kakao-workshop/spacesmart/docs/images/device-screens.png

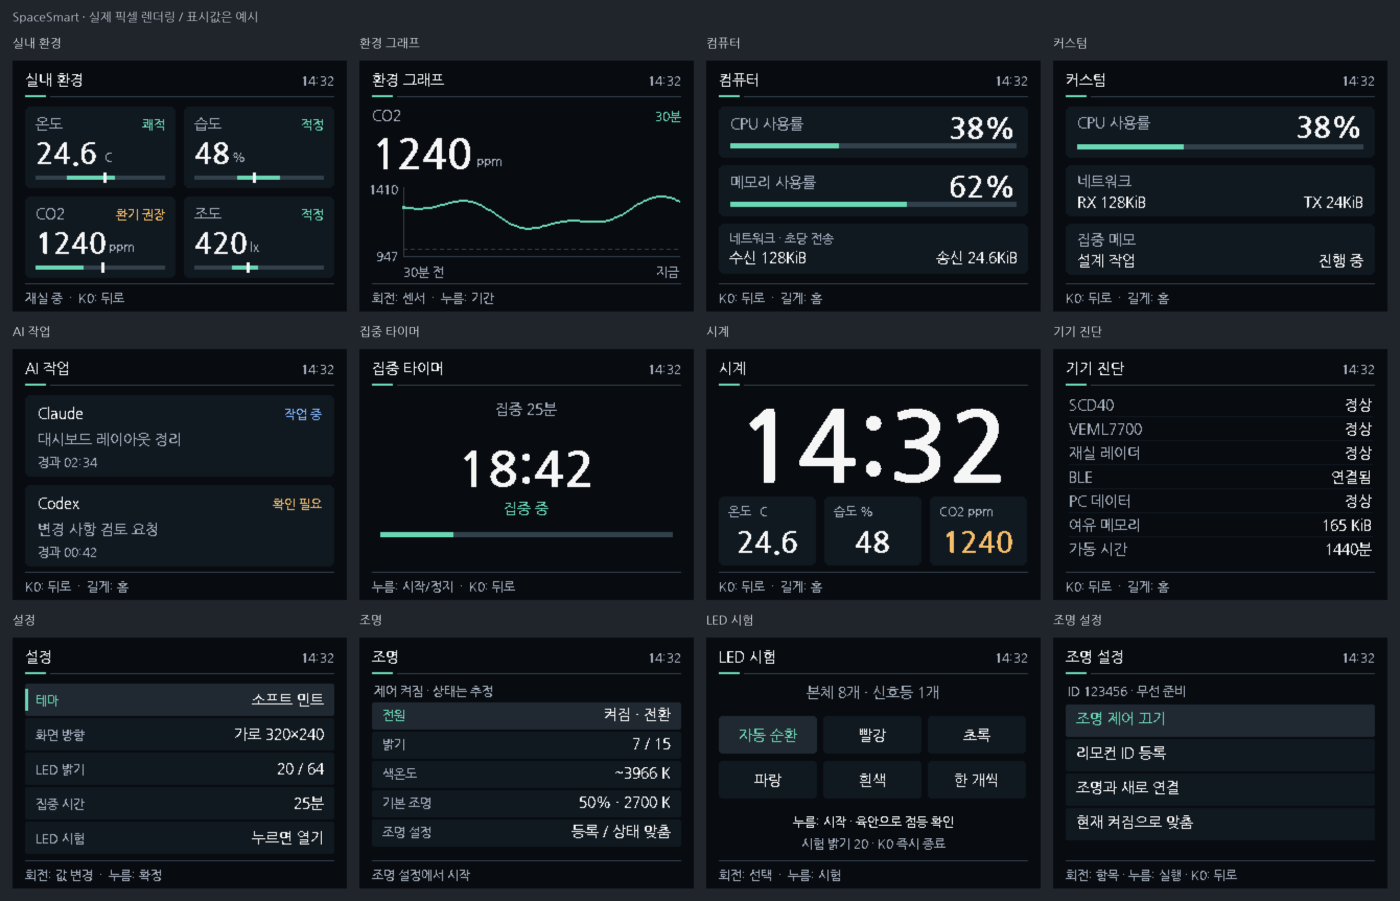
docs/images/device-screens.png
