kakao-workshop/spacesmart/formwork/RevU/dc-slider.png

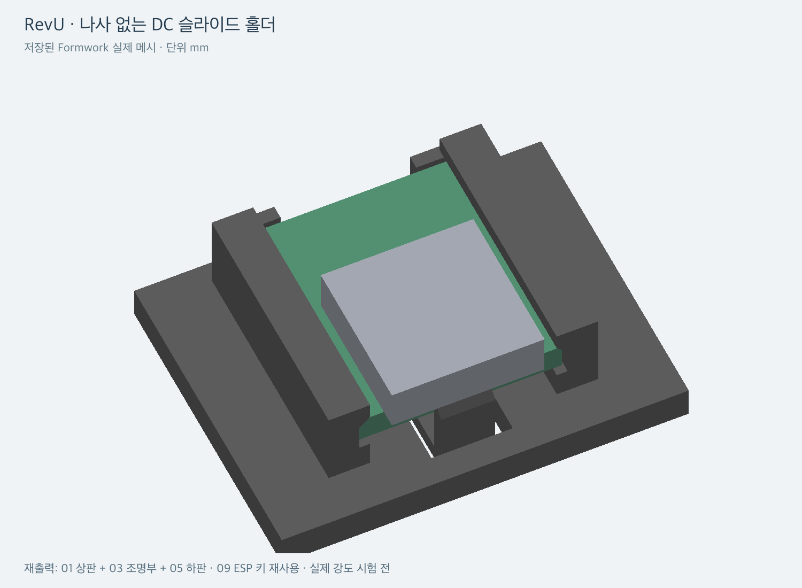
formwork/RevU/dc-slider.png
