kakao-workshop/spacesmart/formwork/RevU/joint-sections.png

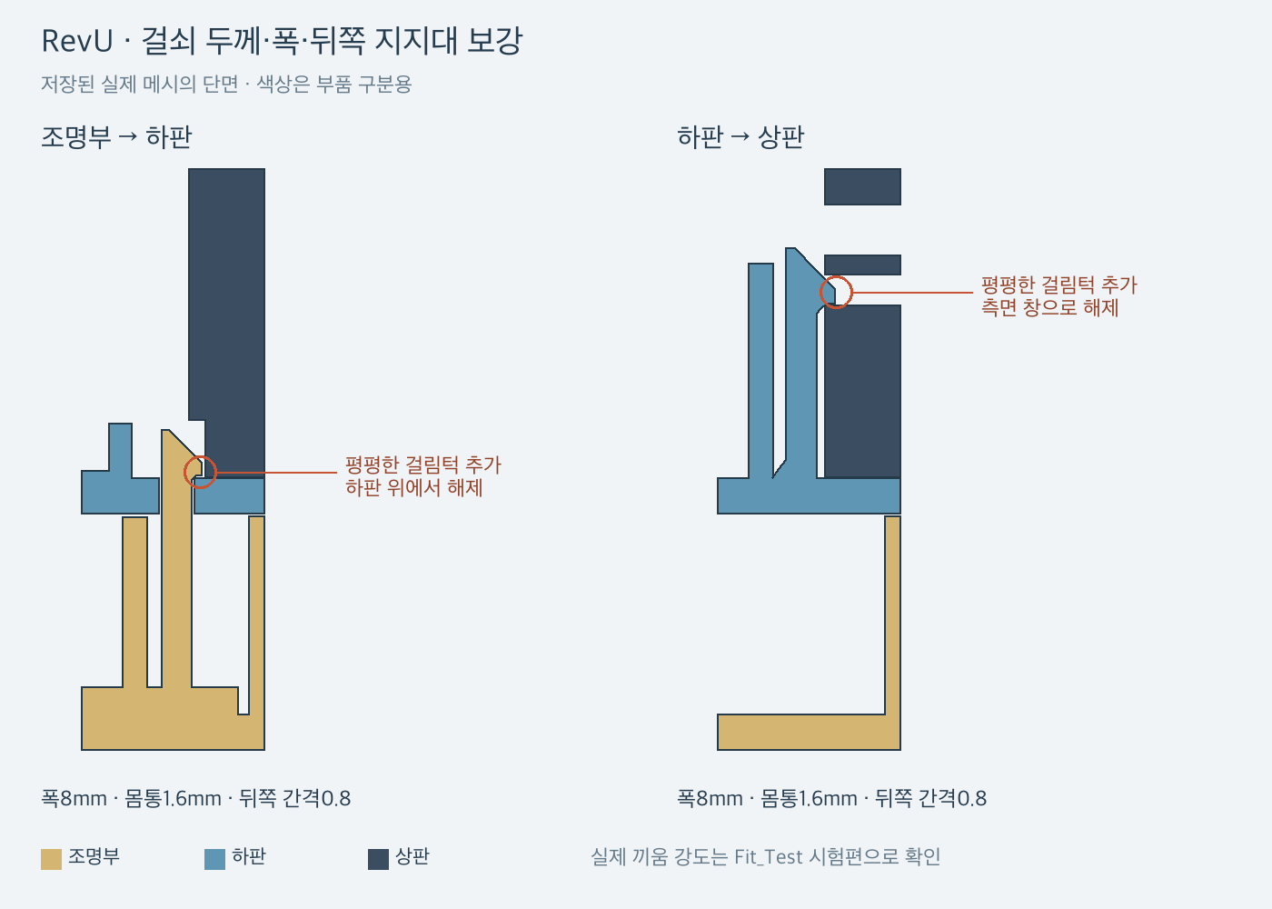
formwork/RevU/joint-sections.png
