kakao-workshop/spacesmart/formwork/RevU/model-joints.png

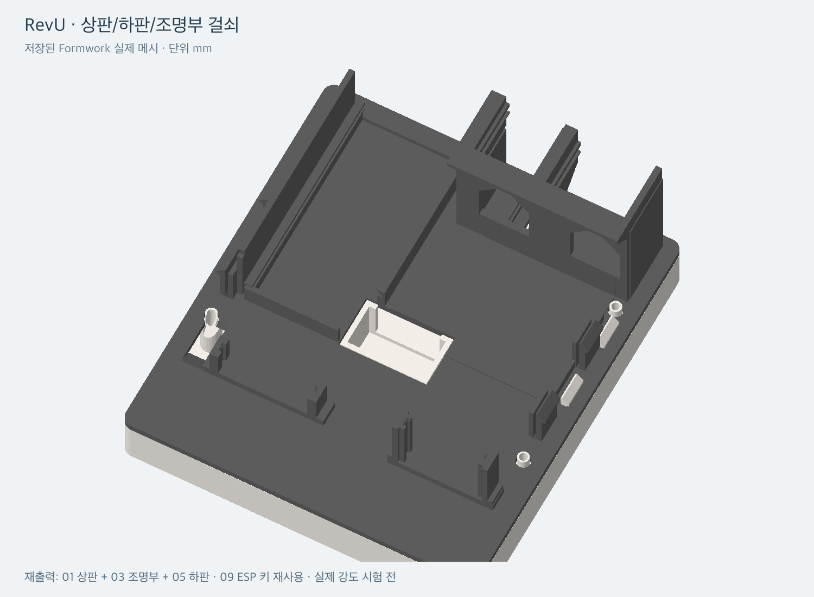
formwork/RevU/model-joints.png
