kakao-workshop/spacesmart/formwork/RevU/STL/01_main_body_black.stl

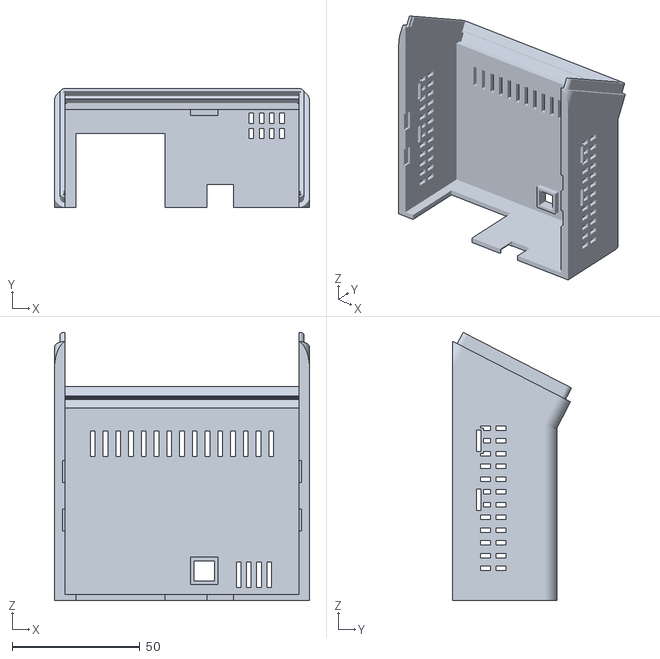
[picture p7: CAD file, 2026-11-02]
formwork/RevU/STL/01_main_body_black.stl
100.0 x 46.7 x 105.3
