kakao-workshop/spacesmart/formwork/RevU/Fit_Test/TEST_03_shell_socket_black.stl

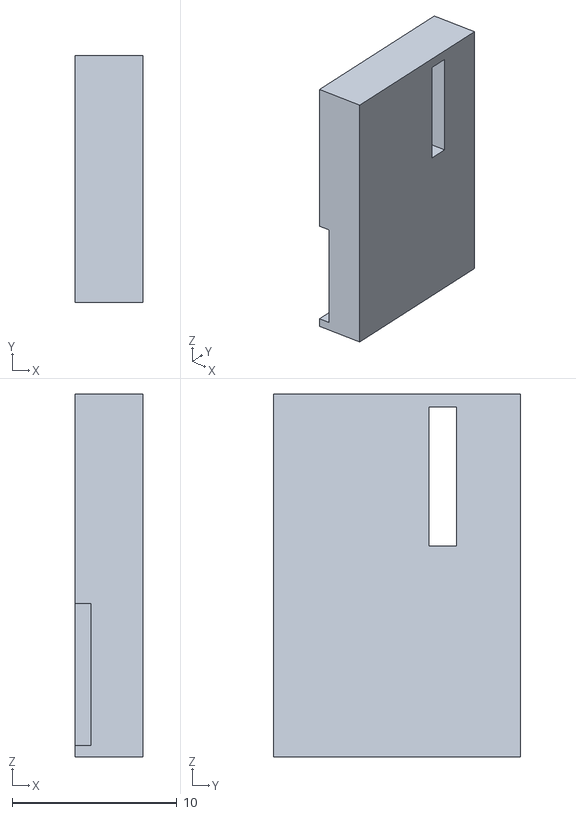
[picture p8: CAD file, 2026-11-02]
formwork/RevU/Fit_Test/TEST_03_shell_socket_black.stl
4.10 x 15.0 x 22.0
