kakao-workshop/spacesmart/formwork/RevU/RevU_A1_0p12_support_off_checked.3mf

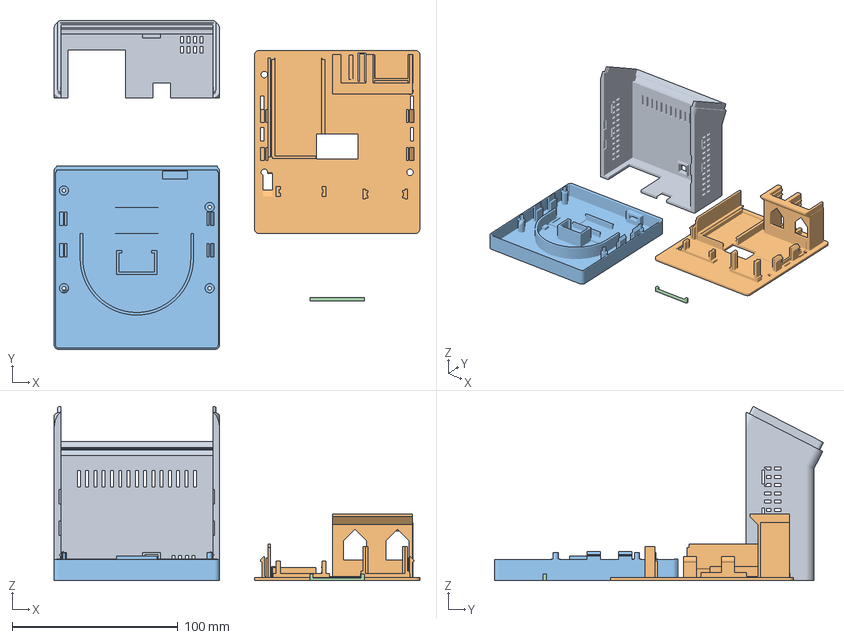
[picture p9: CAD file, 2026-11-02]
formwork/RevU/RevU_A1_0p12_support_off_checked.3mf
221.0 x 198.7 x 105.3 mm
01_main_body_black.stl
05_integrated_slot_tray_black.stl
03_integrated_lower_base_white.stl
09_esp_retainer_black.stl
