kakao-workshop/spacesmart/formwork/RevU/Fit_Test/TEST_02_tray_clip_black.stl

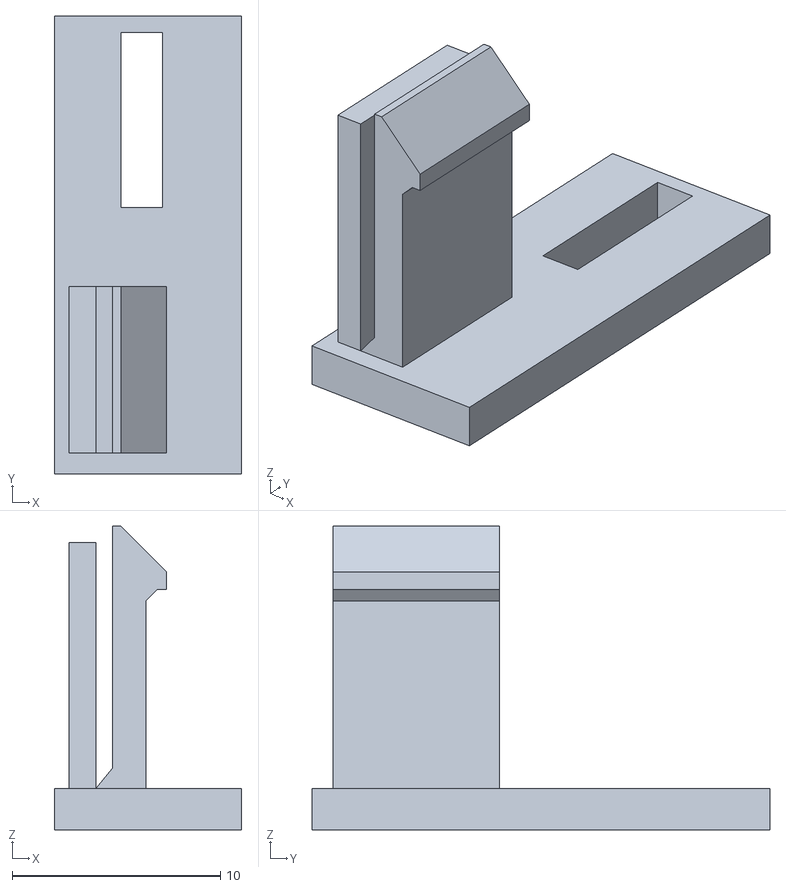
[picture p10: CAD file, 2026-11-02]
formwork/RevU/Fit_Test/TEST_02_tray_clip_black.stl
9.00 x 22.0 x 14.6
