kakao-workshop/spacesmart/formwork/RevU/STL/05_integrated_slot_tray_black.stl

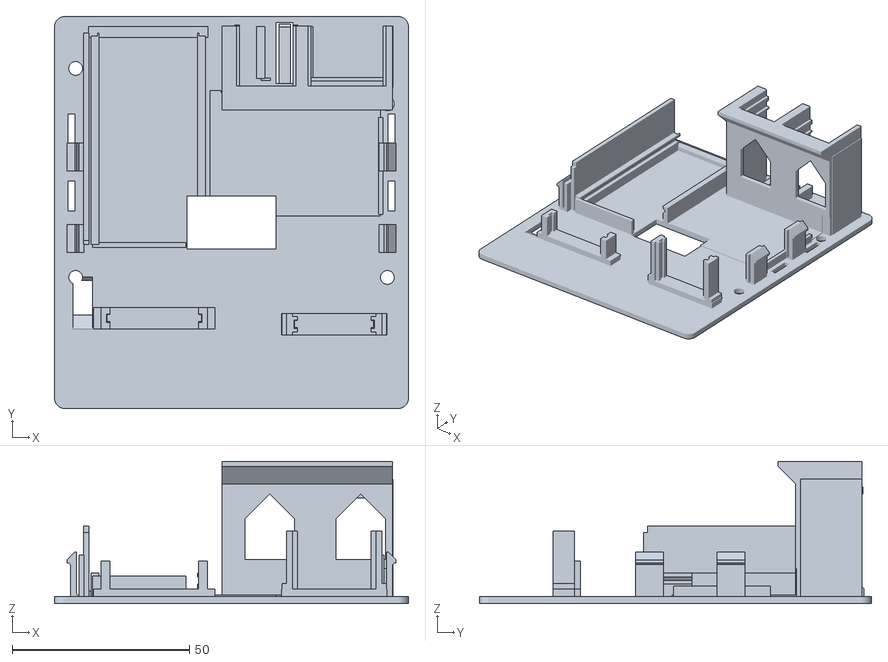
[picture p11: CAD file, 2026-11-02]
formwork/RevU/STL/05_integrated_slot_tray_black.stl
100.0 x 110.7 x 40.2
