kakao-workshop/spacesmart/formwork/RevU/Fit_Test/TEST_01_lower_clip_white.stl

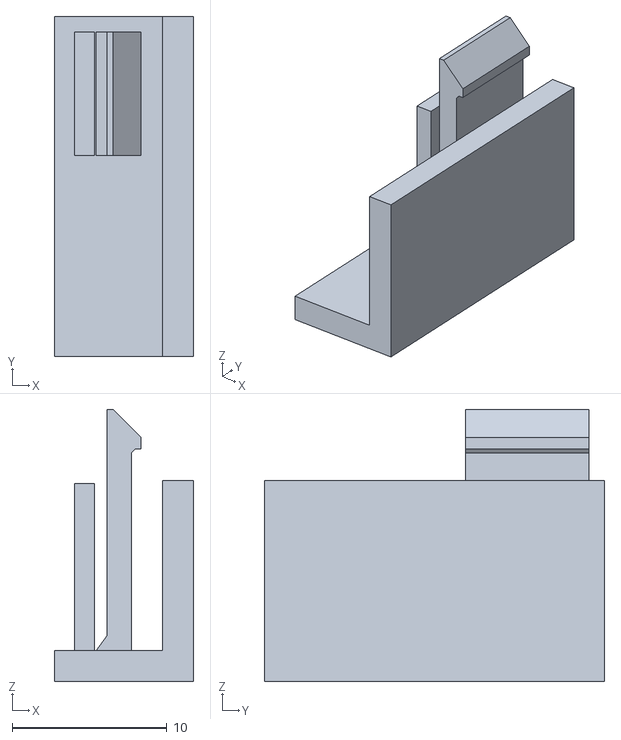
[picture p12: CAD file, 2026-11-02]
formwork/RevU/Fit_Test/TEST_01_lower_clip_white.stl
9.00 x 22.0 x 17.6
