kakao-workshop/spacesmart/formwork/RevU/STL/03_integrated_lower_base_white.stl

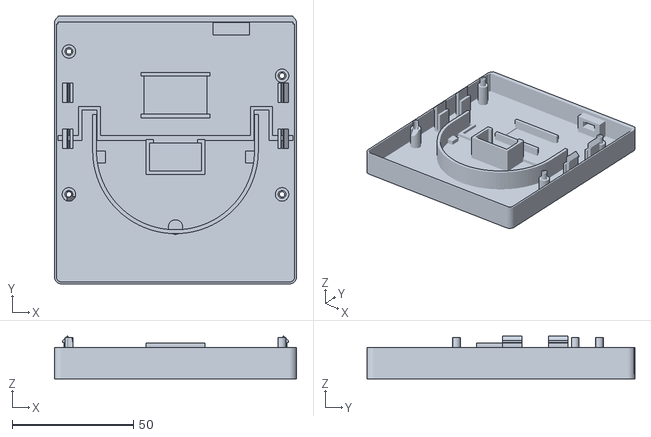
[picture p13: CAD file, 2026-11-02]
formwork/RevU/STL/03_integrated_lower_base_white.stl
100.0 x 110.7 x 17.6
