kakao-workshop/spacesmart/formwork/RevU/STL/09_esp_retainer_black.stl

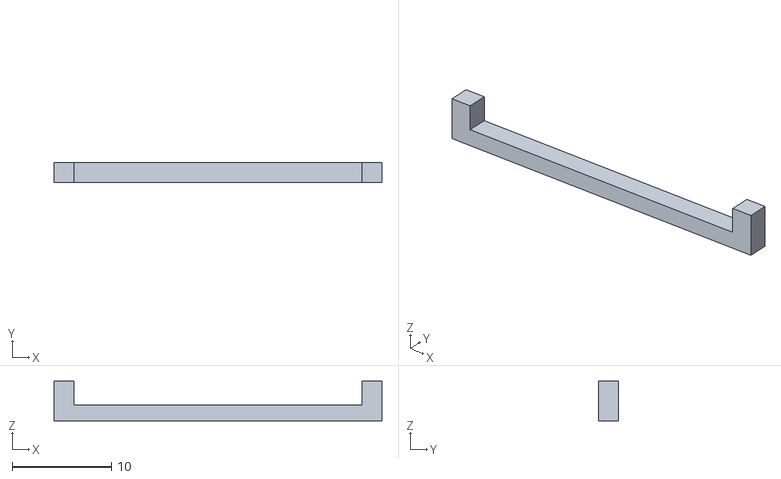
[picture p14: CAD file, 2026-11-02]
formwork/RevU/STL/09_esp_retainer_black.stl
33.0 x 2.00 x 4.00
