kakao-workshop/spacesmart/formwork/RevU/STL/02_original_front_optional_black.stl

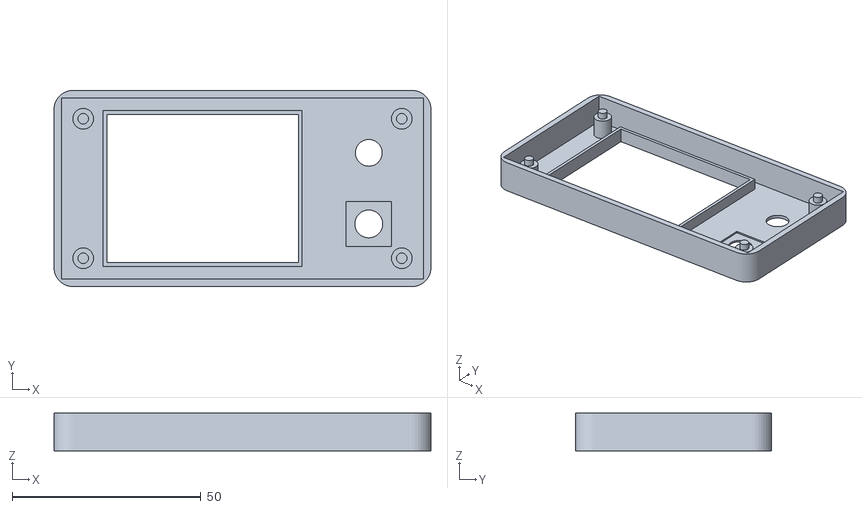
[picture p15: CAD file, 2026-11-02]
formwork/RevU/STL/02_original_front_optional_black.stl
100.0 x 52.0 x 10.0
