kakao-workshop/spacesmart/Arduino/wiring/revk-power-direct-wiring.png

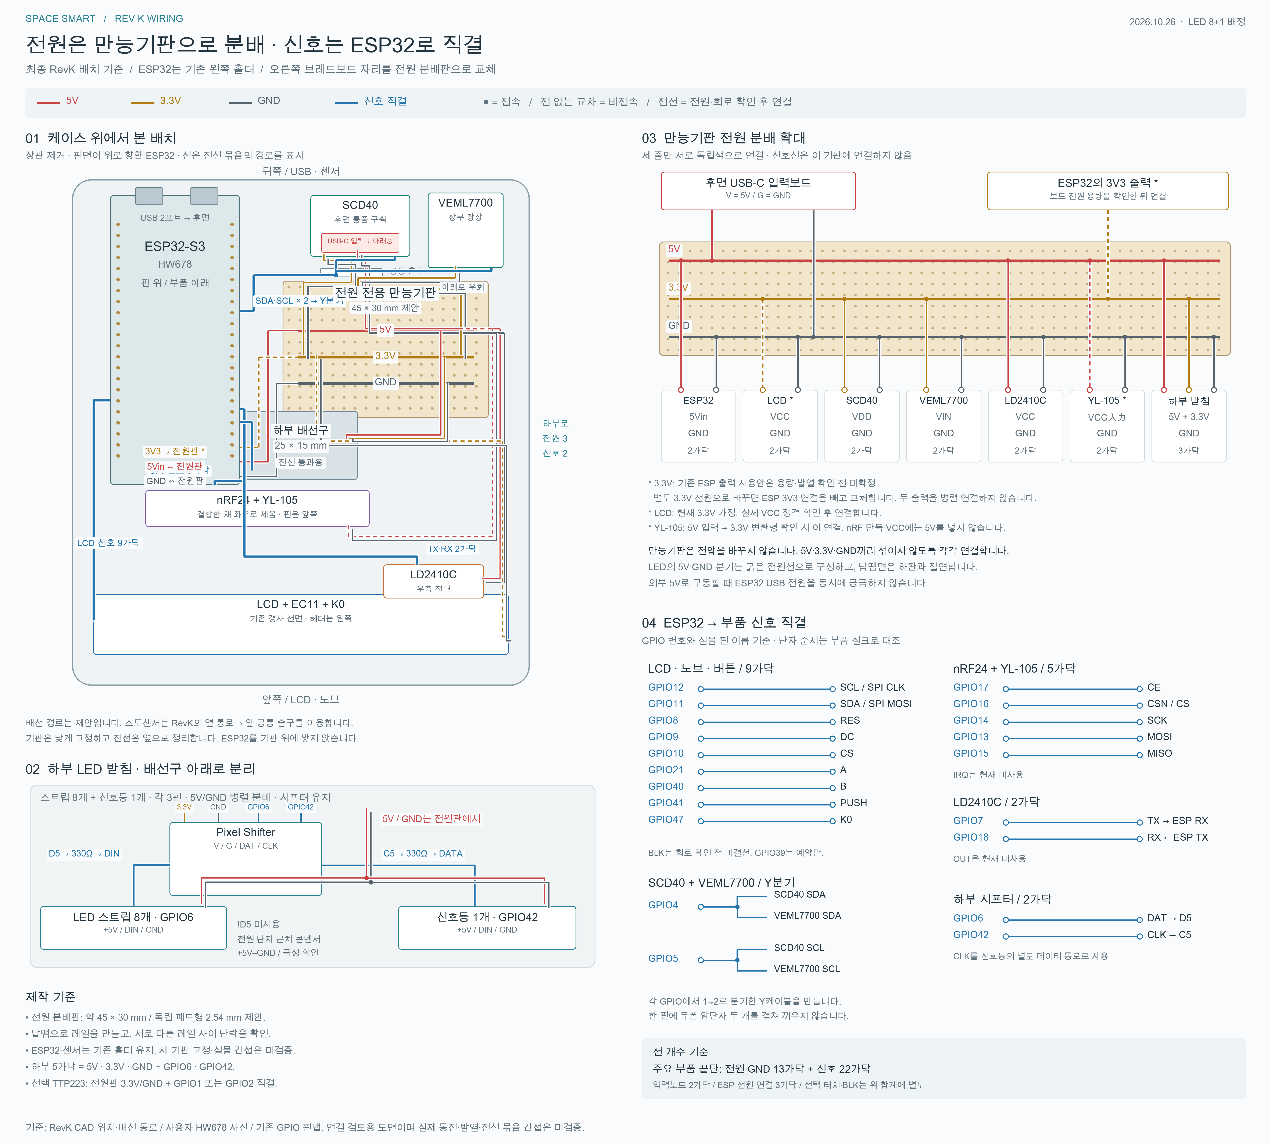
Arduino/wiring/revk-power-direct-wiring.png
