kakao-workshop/spacesmart/docs/VERIFICATION.md

# 검증 범위

기준일: 2026-11-02. 이 문서는 확인한 범위와 아직 실물 확인이 필요한 부분을 구분합니다.

## 완료한 확인

- Arduino: ESP32-S3 N16R8 설정 컴파일, 20개 GPIO와 배선 CSV 대조, 대시보드·노브·LED 시험 로직, 레이더 프레임 파싱.
- 화면: 네 가지 테마·두 방향·12개 화면 상태, 데이터 없는 화면까지 120개 렌더링 검사.
- 실제 기존 디바이스: LCD·온습도·CO₂·조도·재실, LED 기능 활성화, nRF24 칩 응답, Bluetooth와 PC 데이터 전송 확인. 시계·커스텀 화면은 사용자 확인 완료.
- macOS: Apple Silicon/Intel universal 빌드, 서명 검사, 설치·재설치·연동 해제 시 다른 설정 보존, 개인정보 필터·상태 만료, 커스텀 저장.
- v1.3 UI: 단일 창 메뉴 이동, 조명에서 개요 복귀, 단축키, 붙여넣기, 커스텀 입력 유지·저장, 미저장 종료 보호, 작은 창 스크롤, 실제 Bluetooth 재연결과 PC 사용량 갱신.
- 조명 로직: 알려진 패킷 CRC, 수신 정렬, 단계 조절·시간 제한, 명령 보호, 학습 개수·시간·밝기 조건, 위치 분리·저장, 통신 단절 시 자동 조절 중지.
- 케이스 RevU: 저장된 메시·삽입 경로·단면·Bambu A1 슬라이싱 보고서. [세부 보고서](../formwork/RevU/validation-report.json).

공개 저장소의 재구성 후에도 펌웨어 컴파일, C++/Swift 테스트, STL 재생성, macOS universal 빌드와 패키지 검사를 실행합니다.

## 아직 확인이 필요한 범위

- 실제 MJGJD01YL의 RF 제어·원래 리모컨 캡처·현장 밝기 학습·자동 제어.
- v2.3 조명 명령의 전체 실물 통합 동작, 전원 재인가 후 NVS 복원.
- LED 시험 메뉴에서 실제 배선별 LED 점등을 눈으로 확인하는 작업.
- Intel Mac 실물, macOS 13 실물, 새 사용자 계정의 Gatekeeper 설치 흐름.
- 실제 Claude/Codex 앱의 모든 작업 시작·권한 대기·오류·완료 경로.
- 케이스 출력 후 걸쇠 유지력·반복 조립 수명·센서 광학 영향.

컴파일과 테스트는 보드에 자동으로 업로드하지 않습니다. 실제 업로드 시에는 대상 보드를 먼저 확인하세요.
