kakao-workshop/spacesmart/Arduino/docs/CHANGELOG_2_2.txt

SpaceSmart 2.2 / Mac 1.1.0 — 2026-10-31

시계: HH:MM을 가로 96px / 세로 72px로 확대. PC 동기화 안내 문구 제거.
하단 온도·습도·CO2를 28px 중심의 세 카드로 확대. 넓이를 넘는 값은 20px로 조절.

커스텀: 컴퓨터와 같은 카드 3개. 사용률 막대 또는 제목·좌측·우측 텍스트 지원.
Mac 앱 → 커스텀 탭 설정에서 데이터 선택. 기본은 모두 사용 안 함.
CPU·메모리·저장 공간 사용률, 네트워크 RX/TX, 저장 공간 여유/전체, 사용자 텍스트.
Bluetooth 프로토콜은 CUSTOM_PROTOCOL.txt 참고. 기존 레코드와 호환.
빈 카드에는 안내 문구나 항목 번호를 표시하지 않음. 수신이 10초 끊기면 카드 내용을 비움.

LED: PUSH 길게 → 설정 → LED 시험. 노브로 선택, PUSH 시작/중지, K0 종료.
자동 순환·빨강·초록·파랑·흰색·한 개씩. 본체 8개와 신호등 1개.
밝기 20, 최대 15초, 종료 시 기존 밝기와 상태로 복원. PC/BT 연결 불필요.
LED 연결 정상 여부는 실제 점등을 눈으로 확인해야 함.

메인 화면은 9개이며 LED 시험은 설정의 하위 화면입니다.
검증된 초기화 순서·배선·센서 설정·NVS 저장 형식은 유지합니다.
