kakao-workshop/spacesmart/Arduino/SpaceSmart/SpaceSmart.ino

/*
 * SpaceSmart — ESP32-S3 / ST7789 240x320
 * Arduino IDE: open this file; Config.h and SpaceSmartApp.cpp stay in this folder.
 * Wiring: ../wiring/signal-connections.csv
 * Upload instructions: ../README.md
 */
#include "SpaceSmartApp.h"

void setup() { spaceSmartBegin(); }
void loop() { spaceSmartLoop(); }
